Baorunhui/RoboGame/reports/展04宣传总结报告.pdf

## 展 04 宣传报告

阿西莫夫的 fans 队
主要在 bilibili、抖音、QQ 空间进行宣传：

### 1. bilibili：

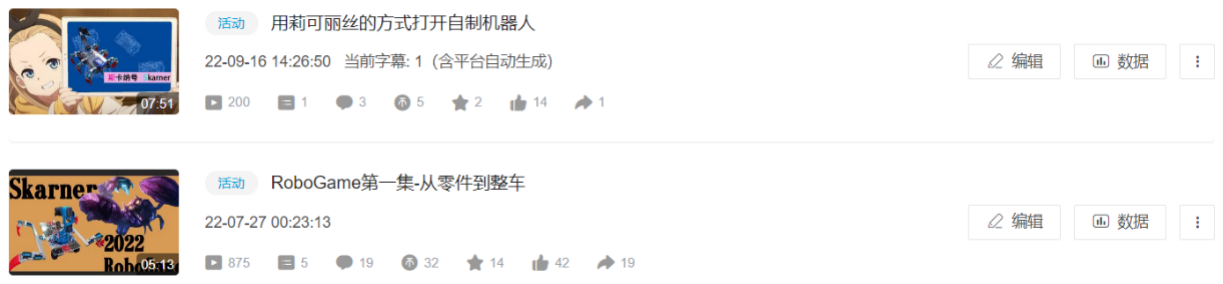
[picture p6: figure]

共投放两个视频，总时长近 13 分钟。收获逾千播放量、56 点赞和 20 次转发

### 2. 抖音：

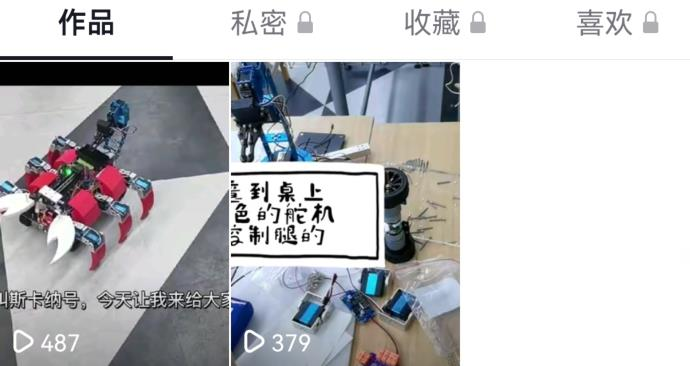
[picture p7: figure]

共投放两个视频，也收获 800 多播放，11 点赞

### 3. QQ 空间：

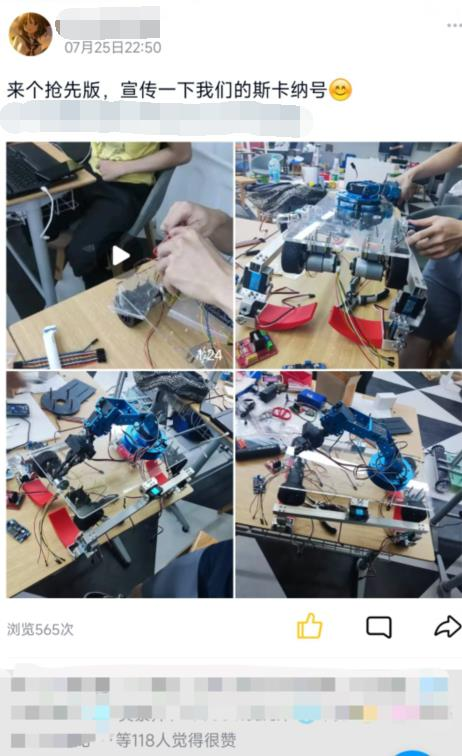
[picture p8: figure]

获得 565 次浏览、118 人点赞
