Baorunhui/RoboGame/MDK-ARM_project/Src/main.c

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
/* Includes ------------------------------------------------------------------*/
#include "main.h"

/* USER CODE BEGIN Includes */
#include "./motor/motor_control.h"
#include "usart.h"
#include "./arm/arm.h"
#include "./foot/foot.h"
#include "./music/music.h"
/* USER CODE END Includes */

TIM_HandleTypeDef htim2;

UART_HandleTypeDef huart4;
UART_HandleTypeDef huart1;
UART_HandleTypeDef huart2;
UART_HandleTypeDef huart3;

void SystemClock_Config(void);
static void MX_GPIO_Init(void);
static void MX_TIM2_Init(void);
static void MX_USART2_UART_Init(void);
static void MX_USART1_UART_Init(void);
static void MX_USART3_UART_Init(void);
static void MX_UART4_Init(void);
/**
  * @brief  The application entry point.
  * @retval int
  */
int main(void)
{
  /* MCU Configuration--------------------------------------------------------*/

  /* Reset of all peripherals, Initializes the Flash interface and the Systick. */
  HAL_Init();

  /* Configure the system clock */
  SystemClock_Config();

  /* Initialize all configured peripherals */
  MX_GPIO_Init();
  MX_TIM2_Init();
  MX_USART2_UART_Init();
  MX_USART1_UART_Init();
  MX_USART3_UART_Init();
  MX_UART4_Init();
  /* USER CODE BEGIN 2 */
//HAL_GPIO_WritePin(GPIOB, LED0_Pin,GPIO_PIN_RESET);
//HAL_Delay(1000);
//HAL_GPIO_WritePin(GPIOB, LED0_Pin,GPIO_PIN_SET);

HAL_TIM_PWM_Start(&htim2, TIM_CHANNEL_1);   //??TIM2??1?PWM,???????PWM??
HAL_TIM_PWM_Start(&htim2, TIM_CHANNEL_2);   //??TIM2??1?PWM,???????PWM??
HAL_Delay(500);
HAL_GPIO_TogglePin(GPIOB, LED0_Pin);
HAL_Delay(500);
HAL_UART_Receive_IT(&huart2,(uint8_t *)&USART2_NewData,1); //??????

uint8_t last_mode = 0xff;

ARM_AHEAD_1();

  /* USER CODE END 2 */

  /* Infinite loop */
  /* USER CODE BEGIN WHILE */
  while (1)
  {
		
		if(USART2_RX_STA&0x8000)              //?????????(??????USART2)
      {
    	 if((USART2_RX_STA&0x7FFF) ==10 	//??????3?                    
    			&& USART2_RX_BUF[0]==0xA5 	//?????1????????0xA5
    			&& USART2_RX_BUF[9]==(USART2_RX_BUF[1] + USART2_RX_BUF[2] + USART2_RX_BUF[3] + USART2_RX_BUF[4] + USART2_RX_BUF[5] + USART2_RX_BUF[6] + USART2_RX_BUF[7] + USART2_RX_BUF[8])%0x100)	//?????????????????8?
    	{
				
				uint8_t move_dir = USART2_RX_BUF[1];
				uint8_t left_speed = USART2_RX_BUF[2];
				uint8_t right_speed = USART2_RX_BUF[3];
				uint8_t arm = USART2_RX_BUF[4];
				uint8_t grasp = USART2_RX_BUF[5];
				uint8_t mode = USART2_RX_BUF[6];
				uint8_t dance = USART2_RX_BUF[7];
				uint8_t save = USART2_RX_BUF[8];
				
				
					switch(left_speed)      //left speed switch
    		 {   //TIM2????ARR???CubeMX????20000
    		 case(0x00):__HAL_TIM_SET_COMPARE(&htim2, TIM_CHANNEL_1,0);break;    //0%???
				 case(0x14):__HAL_TIM_SET_COMPARE(&htim2, TIM_CHANNEL_1,4000) ;break;//20%???
				 case(0x28):__HAL_TIM_SET_COMPARE(&htim2, TIM_CHANNEL_1,8000) ;break;//40%???
				 case(0x3C):__HAL_TIM_SET_COMPARE(&htim2, TIM_CHANNEL_1,12000);break;//60%???
				 case(0x50):__HAL_TIM_SET_COMPARE(&htim2, TIM_CHANNEL_1,16000);break;//80%???
				 case(0x64):__HAL_TIM_SET_COMPARE(&htim2, TIM_CHANNEL_1,20000);break;//100%???
				 default:break;
    		 }
				 
				 switch(right_speed)      //right speed switch
    		 {   //TIM2????ARR???CubeMX????20000
    		 case(0x00):__HAL_TIM_SET_COMPARE(&htim2, TIM_CHANNEL_2,0);break;    //0%???
				 case(0x14):__HAL_TIM_SET_COMPARE(&htim2, TIM_CHANNEL_2,4000) ;break;//20%???
				 case(0x28):__HAL_TIM_SET_COMPARE(&htim2, TIM_CHANNEL_2,8000) ;break;//40%???
				 case(0x3C):__HAL_TIM_SET_COMPARE(&htim2, TIM_CHANNEL_2,12000);break;//60%???
				 case(0x50):__HAL_TIM_SET_COMPARE(&htim2, TIM_CHANNEL_2,16000);break;//80%???
				 case(0x64):__HAL_TIM_SET_COMPARE(&htim2, TIM_CHANNEL_2,20000);break;//100%???
				 default:break;
    		 }
				 
    		 switch(mode)
				 {
					 case(0x00):			//car move
					 {
						 if(last_mode != 0xff && last_mode != mode)	//switch to car
						 {
							TO_CAR();
							 
							//hand
							//RESET: back
							//SET: forward
							HAL_GPIO_WritePin(GPIOF ,GPIO_PIN_13,GPIO_PIN_RESET );
							HAL_TIM_PWM_Start(&htim8,TIM_CHANNEL_2);
							HAL_Delay (1000);
							HAL_TIM_PWM_Stop(&htim8,TIM_CHANNEL_2);
							 
						 }
						 switch(move_dir)      //motion switch
						 {
							 case(0x01):CAR_GO();break;
							 case(0x02):CAR_RGO();break;
							 case(0x03):CAR_LGO();break;
							 case(0x04):CAR_BACK();break;
							 case(0x00):CAR_STOP();break;
							 default:break;
						 }
						 break;
					 }
						case(0x01):				//foot mode (tri)
						{
							if(last_mode != 0xff && last_mode != mode && last_mode !=0x02 )	//switch to foot
						 {
							TO_FOOT();
								
							//hand
							//RESET: back
							//SET: forward
							HAL_GPIO_WritePin(GPIOF ,GPIO_PIN_13,GPIO_PIN_SET );
							HAL_TIM_PWM_Start(&htim8,TIM_CHANNEL_2);
							HAL_Delay (1000);
							HAL_TIM_PWM_Stop(&htim8,TIM_CHANNEL_2);
								
						 }
						 switch(move_dir)      //motion switch
						 {
							 case(0x01):
							 {
								 //MUSIC_WALK();
								 TRIWALK_AHEAD();
								 break;
							 }
							 case(0x02):TRIWALK_LEFT();break;
							 case(0x03):TRIWALK_RIGHT();break;
							 case(0x04):TRIWALK_BACK();break;
							 case(0x00):FOOT_INIT();break;
							 default:break;
						 }
						 
						 if(dance == 0x01)
						 {
								DANCE_WAVE();
								//MUSIC_WAVE();
						 }
						 break;
						}
						case(0x02):				//foot mode (wave)
						{
							if(last_mode != 0xff && last_mode != mode && last_mode !=0x01 )	//switch to foot
						 {
							TO_FOOT();
								
							//hand
							//RESET: back
							//SET: forward
							HAL_GPIO_WritePin(GPIOF ,GPIO_PIN_13,GPIO_PIN_SET );
							HAL_TIM_PWM_Start(&htim8,TIM_CHANNEL_2);
							HAL_Delay (1000);
							HAL_TIM_PWM_Stop(&htim8,TIM_CHANNEL_2);
								
						 }
							switch(move_dir)      //motion switch
							{
							 case(0x01):WAVEWALK_AHEAD();break;
							 case(0x02):WAVEWALK_LEFT();break;
							 case(0x03):WAVEWALK_RIGHT();break;
							 case(0x04):WAVEWALK_BACK();break;
							 case(0x00):FOOT_INIT();break;
							 default:break;
						 }
							
						 if(dance == 0x01)
						 {
								DANCE_UP_DOWN();
								//MUSIC_UP_DOWN();
						 }
						 break;
						}
						case(0x03):				//box mode 
						{
							if(last_mode != 0xff && last_mode != mode)	//switch to box
						 {
							TO_BOX();
							if(last_mode == 0x00)
							 {
								 
							 }
							 else if(last_mode == 0x01 || last_mode == 0x02)
							 {
								//hand
								//RESET: back
								//SET: forward
								HAL_GPIO_WritePin(GPIOF ,GPIO_PIN_13,GPIO_PIN_RESET );
								HAL_TIM_PWM_Start(&htim8,TIM_CHANNEL_2);
								HAL_Delay (1000);
								HAL_TIM_PWM_Stop(&htim8,TIM_CHANNEL_2);
							 }	
						 }
							
						}
						default:break;
				 }
				 
				 switch(grasp)      //grasp control
    		 {
					case(0x01):ARM_GRASP();break;
					case(0x00):ARM_RELEASE();break;
    		 default:break;
    		 }
				 
				 switch(arm)      //arm control
    		 {
					 case(0x9C):ARM_BACK_2();break;
					 case(0xce):ARM_BACK_1();break;
					 case(0x00):ARM_MID();break;
					 case(0x32):ARM_AHEAD_1();break;
					 case(0x64):ARM_AHEAD_2(); break;
    		 default:break;
    		 }
				 
				 last_mode = mode;
    	 }
       USART2_RX_STA=0;//????0,??????
			 
			 
      }
    /* USER CODE END WHILE */

    /* USER CODE BEGIN 3 */
  }
  /* USER CODE END 3 */
}

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
