Baorunhui/RoboGame/MDK-ARM_project/try3.ioc

Mcu.UserName=STM32F103ZETx
PA1.GPIO_Label=IN1
PA1.Signal=GPIO_Output
PA10.Signal=USART1_RX
PA13.Signal=SYS_JTMS-SWDIO
PA14.Signal=SYS_JTCK-SWCLK
PA15.GPIO_Label=motor_speed_left
PA15.Signal=S_TIM2_CH1_ETR
PA2.GPIO_Label=IN2
PA2.Signal=GPIO_Output
PA3.GPIO_Label=IN3
PA3.Signal=GPIO_Output
PA4.GPIO_Label=IN4
PA4.Signal=GPIO_Output
PA5.GPIO_Label=IN11
PA5.Signal=GPIO_Output
PA6.GPIO_Label=IN22
PA6.Signal=GPIO_Output
PA7.GPIO_Label=IN33
PA7.Signal=GPIO_Output
PA8.GPIO_Label=IN44
PA8.Signal=GPIO_Output
PA9.Signal=USART1_TX
PB10.Signal=USART3_TX
PB11.Signal=USART3_RX
PB3.GPIO_Label=motor_speed_right
PB3.Signal=S_TIM2_CH2
PB5.GPIO_Label=LED0
PB5.Signal=GPIO_Output
PC10.Signal=UART4_TX
PC11.Signal=UART4_RX
PC14-OSC32_IN.Signal=RCC_OSC32_IN
PC15-OSC32_OUT.Signal=RCC_OSC32_OUT
PD5.Signal=USART2_TX
PD6.Signal=USART2_RX
PE3.Signal=GPXTI3
PE4.Signal=GPXTI4
PE5.GPIO_Label=LED1
PE5.Signal=GPIO_Output
